MRKane05/PiPortableProject/AdditionalLibraries/NanoPI_Duo2-master/MotherPCB.jpg

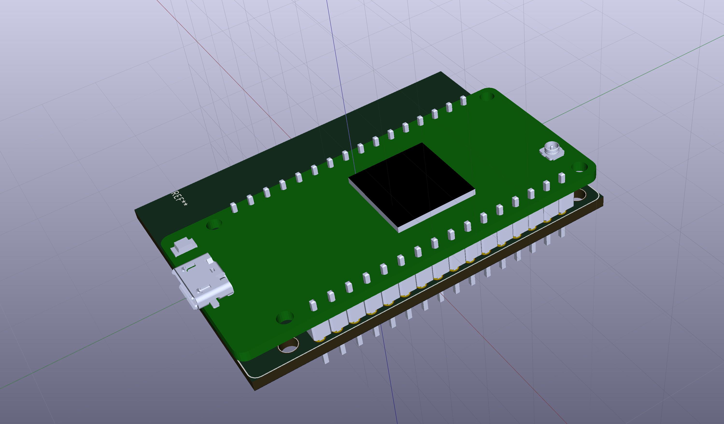
AdditionalLibraries/NanoPI_Duo2-master/MotherPCB.jpg
