MRKane05/PiPortableProject/AdditionalLibraries/NanoPI_Duo2-master/README.md

# NanoPI_Duo2
KICAD Footprint and WRL for the NANOPI DUO2
