MRKane05/PiPortableProject/AdditionalLibraries/NanoPI_Duo2-master/Duo_pinout2-02.jpg

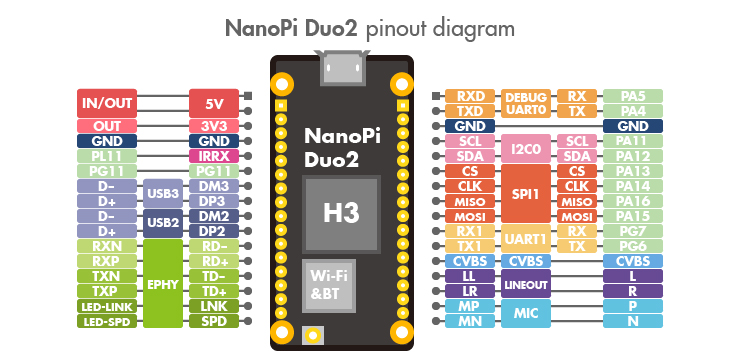
AdditionalLibraries/NanoPI_Duo2-master/Duo_pinout2-02.jpg
