MRKane05/PiPortableProject/(threads)

Thread 1 (2021-07-16):

ATMega32U4

MRKane05, 2021-07-16:
Chip appears to be programmable through both the ISP and USB, but devices won't recognise it as a controller when programmed.

Thread 2 (2021-07-16):

TPS61230 output voltage same as input voltage

MRKane05, 2021-07-16:
The TPS61230 (TP) is supposed to boost the LiPo input voltage up to 5v but for some reason is only outputting the input voltage. I've a suspicion that this is due to the arrangement of the inductors between the TP and BQ25895m (BQ).

Personally I'd like to replace the TP with something that outputs a higher amperage just to cover all bases.

Thread 3 (2021-07-17):

Audio system not working and electrical noise

MRKane05, 2021-07-17:
Raspberry Pi appears to recognise the PCM5102 Audio DAC but isn't pushing any sound through. There's electrical noise on the speakers after the PAM8403 but when headphones are plugged in none is present. I'm yet to test the PAM8403 in isolation.
