MRKane05/PiPortableProject/BoardDesign_FullRouting.pdf

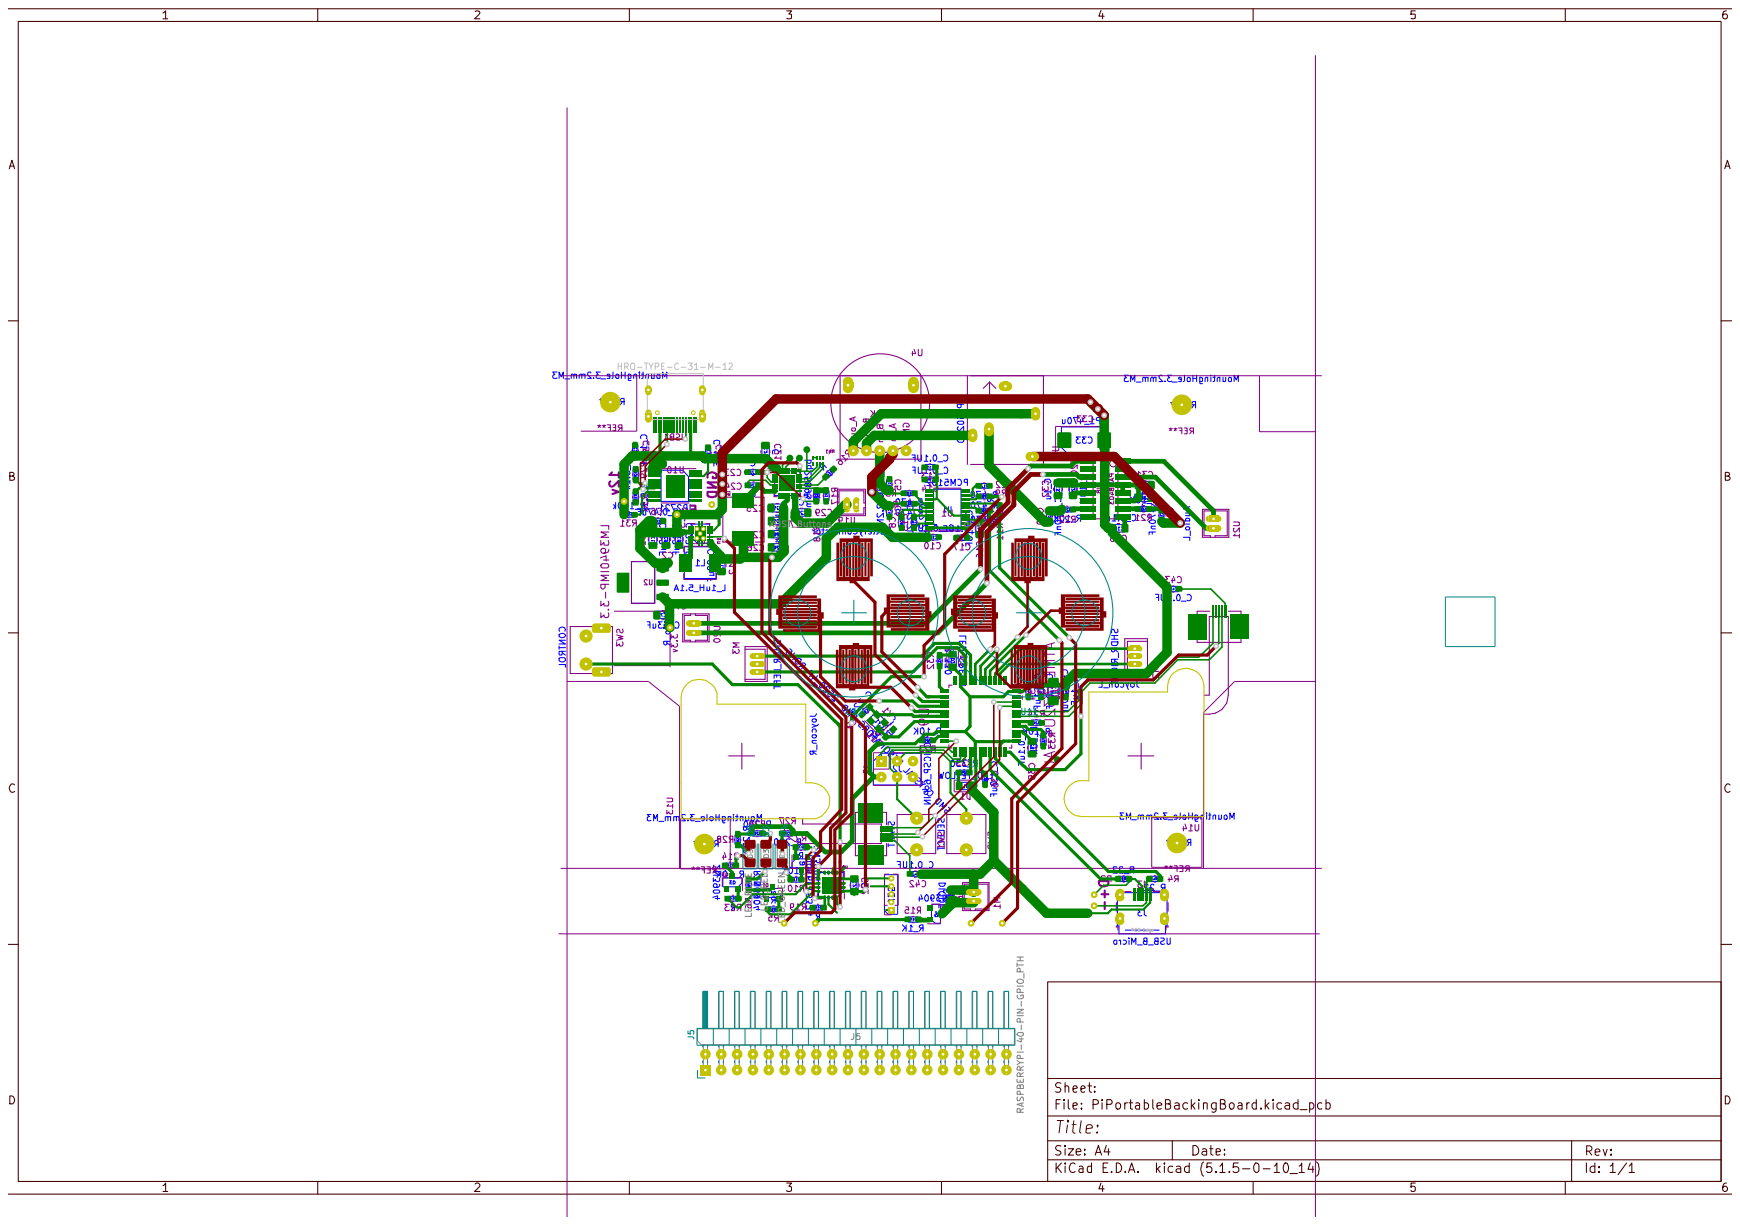
[picture p4: page 1]
