MRKane05/PiPortableProject/PiPortableBackingBoard.kicad_pcb

## KiCad design PiPortableBackingBoard.kicad_pcb (2021-07-16)

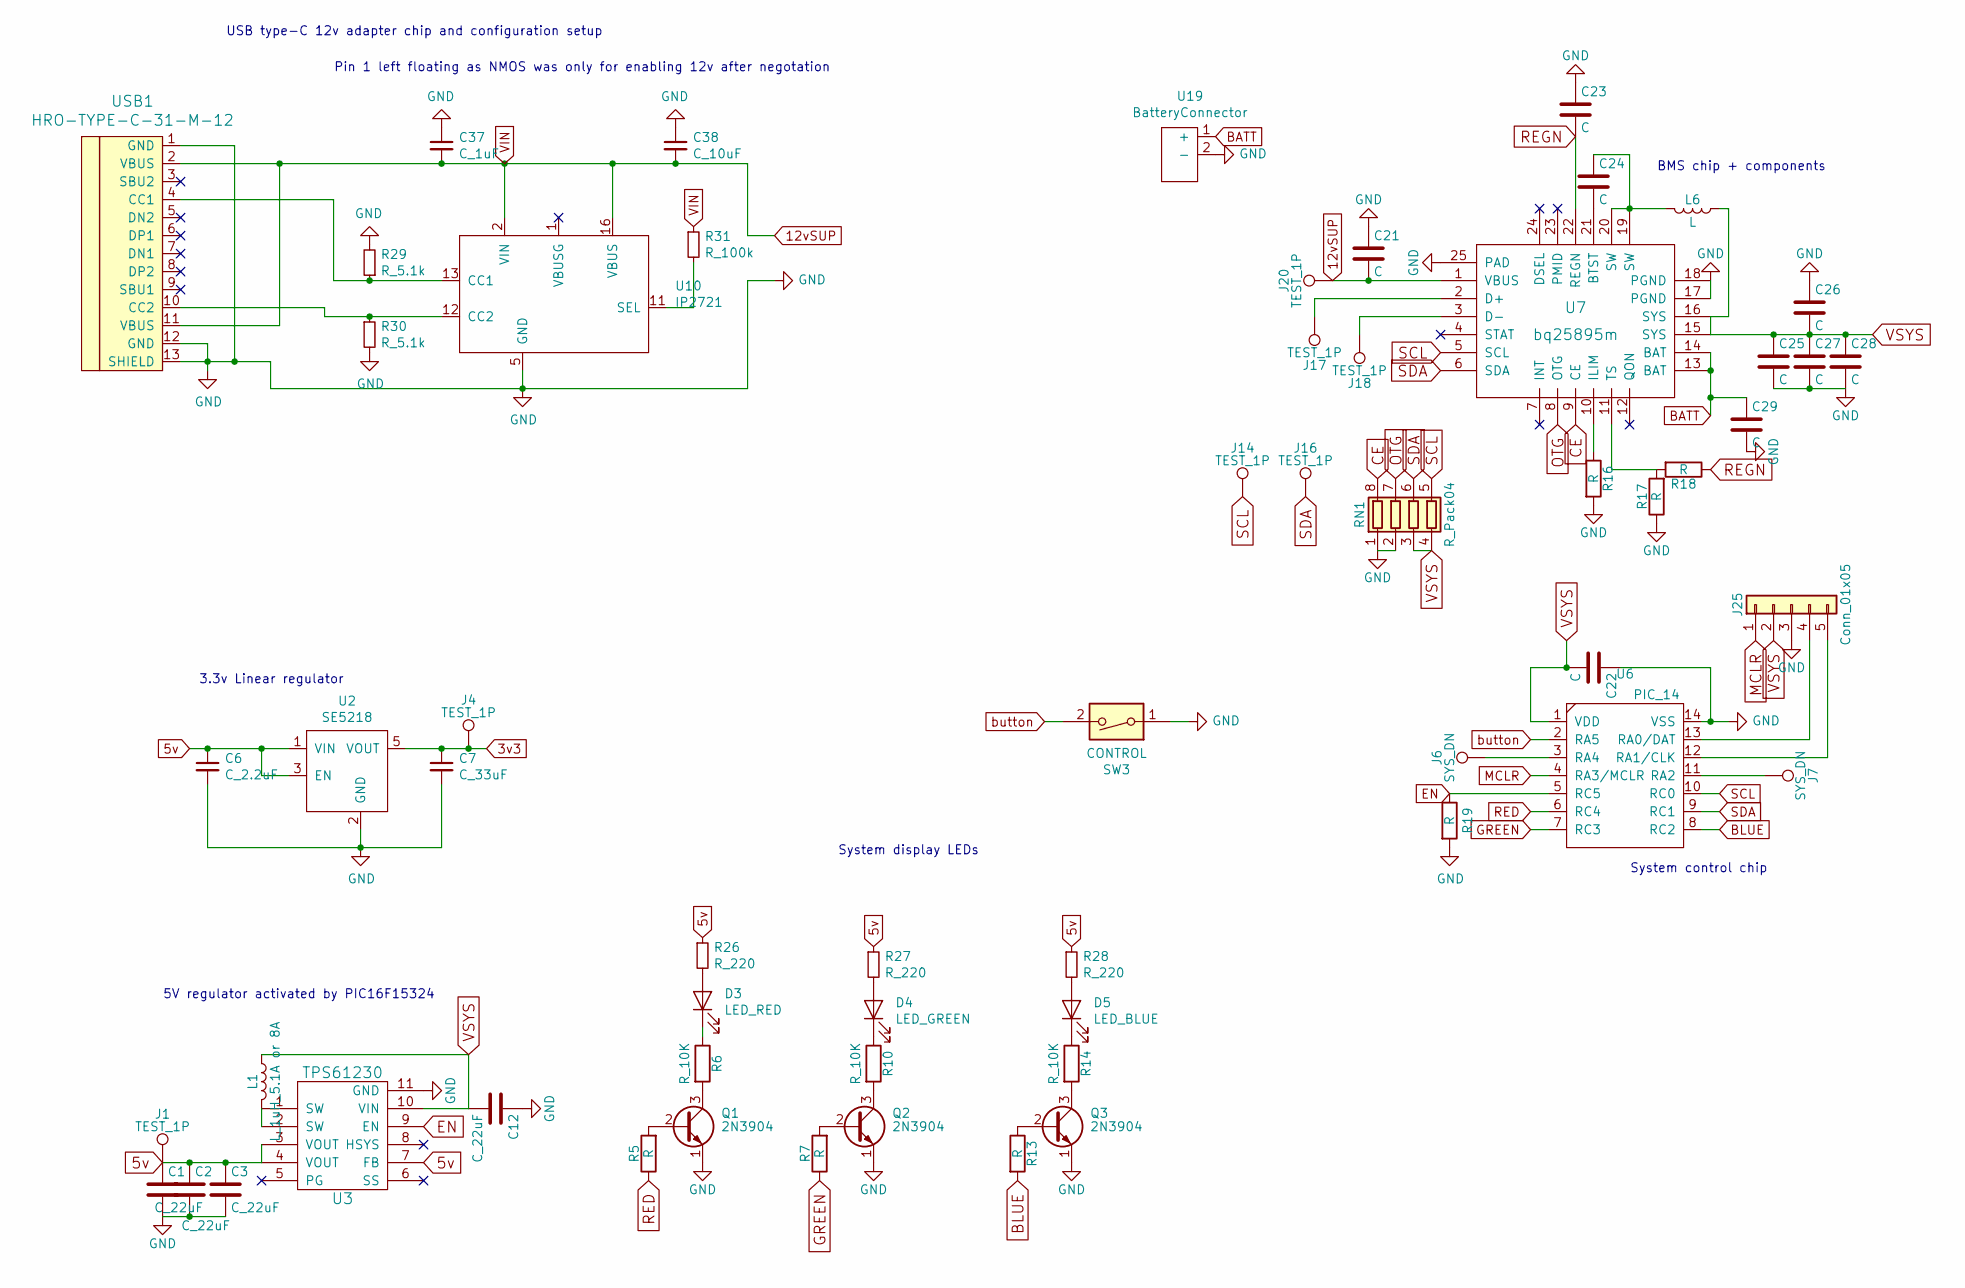
[picture p5: schematic PMSSystem.sch]

Parts:
C1, C2, C3, C12: C_22uF; C_0805_2012Metric_Pad1.15x1.40mm_HandSolder; LCSC C5674
C6: C_2.2uF; C_0603_1608Metric_Pad1.05x0.95mm_HandSolder; LCSC C23630
C7: C_33uF; C_0603_1608Metric_Pad1.05x0.95mm_HandSolder; LCSC C23630
C21, C22, C25, C26, C27, C28, C29: C; C_0805_2012Metric_Pad1.15x1.40mm_HandSolder; LCSC C89190
C23: C; C_0603_1608Metric_Pad1.05x0.95mm_HandSolder; LCSC C19666
C24: C; C_0603_1608Metric_Pad1.05x0.95mm_HandSolder; LCSC C1622
C37: C_1uF; C_0603_1608Metric_Pad1.05x0.95mm_HandSolder; LCSC C15849
C38: C_10uF; C_0603_1608Metric_Pad1.05x0.95mm_HandSolder; LCSC C96446
D3: LED_RED; LED_1206_3216Metric_Pad1.42x1.75mm_HandSolder
D4: LED_GREEN; LED_1206_3216Metric_Pad1.42x1.75mm_HandSolder
D5: LED_BLUE; LED_1206_3216Metric_Pad1.42x1.75mm_HandSolder
J1, J4, J20: TEST_1P; TP1_THT
J6, J7: SYS_DN; TP1_THT
J14, J16, J17, J18: TEST_1P; TP1
J25: Conn_01x05; Pin_Header_Straight_1x05_Pitch1.27mm
L1: L_1uH_5.1A or 8A; ASPI-0630HI-2R2M-T15; LCSC C475532
L6: L; ASPI-0630HI-2R2M-T15; LCSC C475532
Q1, Q2, Q3: 2N3904; SOT-23_custom; LCSC C382287
R5, R7, R13, R17, R18, R19: R; R_0603_1608Metric_Pad1.05x0.95mm_HandSolder; LCSC C25804
R6, R10, R14: R_10K; R_0603_1608Metric_Pad1.05x0.95mm_HandSolder; LCSC C22775
R16: R; R_0603_1608Metric_Pad1.05x0.95mm_HandSolder; LCSC C22925
R26, R27, R28: R_220; R_0603_1608Metric_Pad1.05x0.95mm_HandSolder; LCSC C22962
R29, R30: R_5.1k; R_0603_1608Metric_Pad1.05x0.95mm_HandSolder; LCSC C23186
R31: R_100k; R_0603_1608Metric_Pad1.05x0.95mm_HandSolder; LCSC C25803
RN1: R_Pack04; RA_0804; LCSC C25725
SW3: CONTROL; RightAngleTact
U2: SE5218; SOT-23-5_HandSoldering; LCSC C118233
U3: TPS61230; VSON-10-1EP_3x3mm_Pitch0.5mm_ThermalPad; LCSC C139626
U6: PIC_14; DIP-14_W7.62mm_LongPads
U7: bq25895m; QFN-24-1EP_4x4mm_Pitch0.5mm; LCSC C80200
U10: IP2721; TSSOP-16-1EP_4.4x5mm_P0.65mm_HandSolder
U19: BatteryConnector; JST_1.5_2Pin
USB1: HRO-TYPE-C-31-M-12; HRO-TYPE-C-31-M-12-HandSoldering; LCSC C165948

Connections:
3v3: C7.1, J4.1, U2.5 (VOUT); also elsewhere on the board
5v: C1.1, C2.1, C3.1, C6.1, J1.1, R26.1, R27.1, R28.1, U2.1 (VIN), U2.3 (EN), U3.3 (VOUT), U3.4 (VOUT), U3.7 (FB); also elsewhere on the board
12vSUP: C21.2, C37.2, C38.2, J20.1, R31.1, U7.1 (VBUS), U10.2 (VIN), U10.16 (VBUS), USB1.2 (VBUS), USB1.11 (VBUS)
BATT: C29.1, U7.13 (BAT), U7.14 (BAT), U19.1 (+)
BLUE: R13.2, U6.8 (RC2)
CE: RN1.8 (R1.2), U7.9 (CE)
EN: R19.1, U3.9 (EN), U6.5 (RC5)
GREEN: R7.1, U6.7 (RC3)
MCLR: J25.1, U6.4 (RA3/MCLR)
unnamed: C24.1, L6.2, U7.19 (SW), U7.20 (SW)
unnamed: C24.2, U7.21 (BTST)
unnamed: D3.1 (K), R6.1
unnamed: D3.2 (A), R26.2
unnamed: D4.1 (K), R10.1
unnamed: D4.2 (A), R27.2
unnamed: D5.1 (K), R14.1
unnamed: D5.2 (A), R28.2
unnamed: J6.1, U6.3 (RA4)
unnamed: J7.1, U6.11 (RA2)
unnamed: J17.1, U7.2 (D+)
unnamed: J18.1, U7.3 (D-)
unnamed: J25.4, U6.13 (RA0/DAT)
unnamed: J25.5, U6.12 (RA1/CLK)
unnamed: L1.2, U3.1 (SW), U3.2 (SW)
unnamed: Q1.2 (B), R5.2
unnamed: Q1.3 (C), R6.2
unnamed: Q2.2 (B), R7.2
unnamed: Q2.3 (C), R10.2
unnamed: Q3.2 (B), R13.1
unnamed: Q3.3 (C), R14.2
unnamed: R16.1, U7.10 (ILIM)
unnamed: R17.2, R18.2, U7.11 (TS)
unnamed: R29.1, U10.13 (CC1), USB1.4 (CC1)
unnamed: R30.1, U10.12 (CC2), USB1.10 (CC2)
unnamed: R31.2, U10.11 (SEL)
OTG: RN1.7 (R2.2), U7.8 (OTG)
RED: R5.1, U6.6 (RC4)
REGN: C23.2, R18.1, U7.22 (REGN)
SDA: J16.1, RN1.6 (R3.2), U6.9 (RC1), U7.6 (SDA)
VSYS: C12.2, C22.2, C25.1, C26.2, C27.1, C28.1, J25.2, L1.1, L6.1, RN1.3 (R3.1), RN1.4 (R4.1), U3.10 (VIN), U6.1 (VDD), U7.15 (SYS), U7.16 (SYS)
button: SW3.2, U6.2 (RA5)

Notes on the sheet:
System display LEDs
3.3v Linear regulator
5V regulator activated by PIC16F15324
BMS chip + components
System control chip
USB type-C 12v adapter chip and configuration setup
Pin 1 left floating as NMOS was only for enabling 12v after negotation

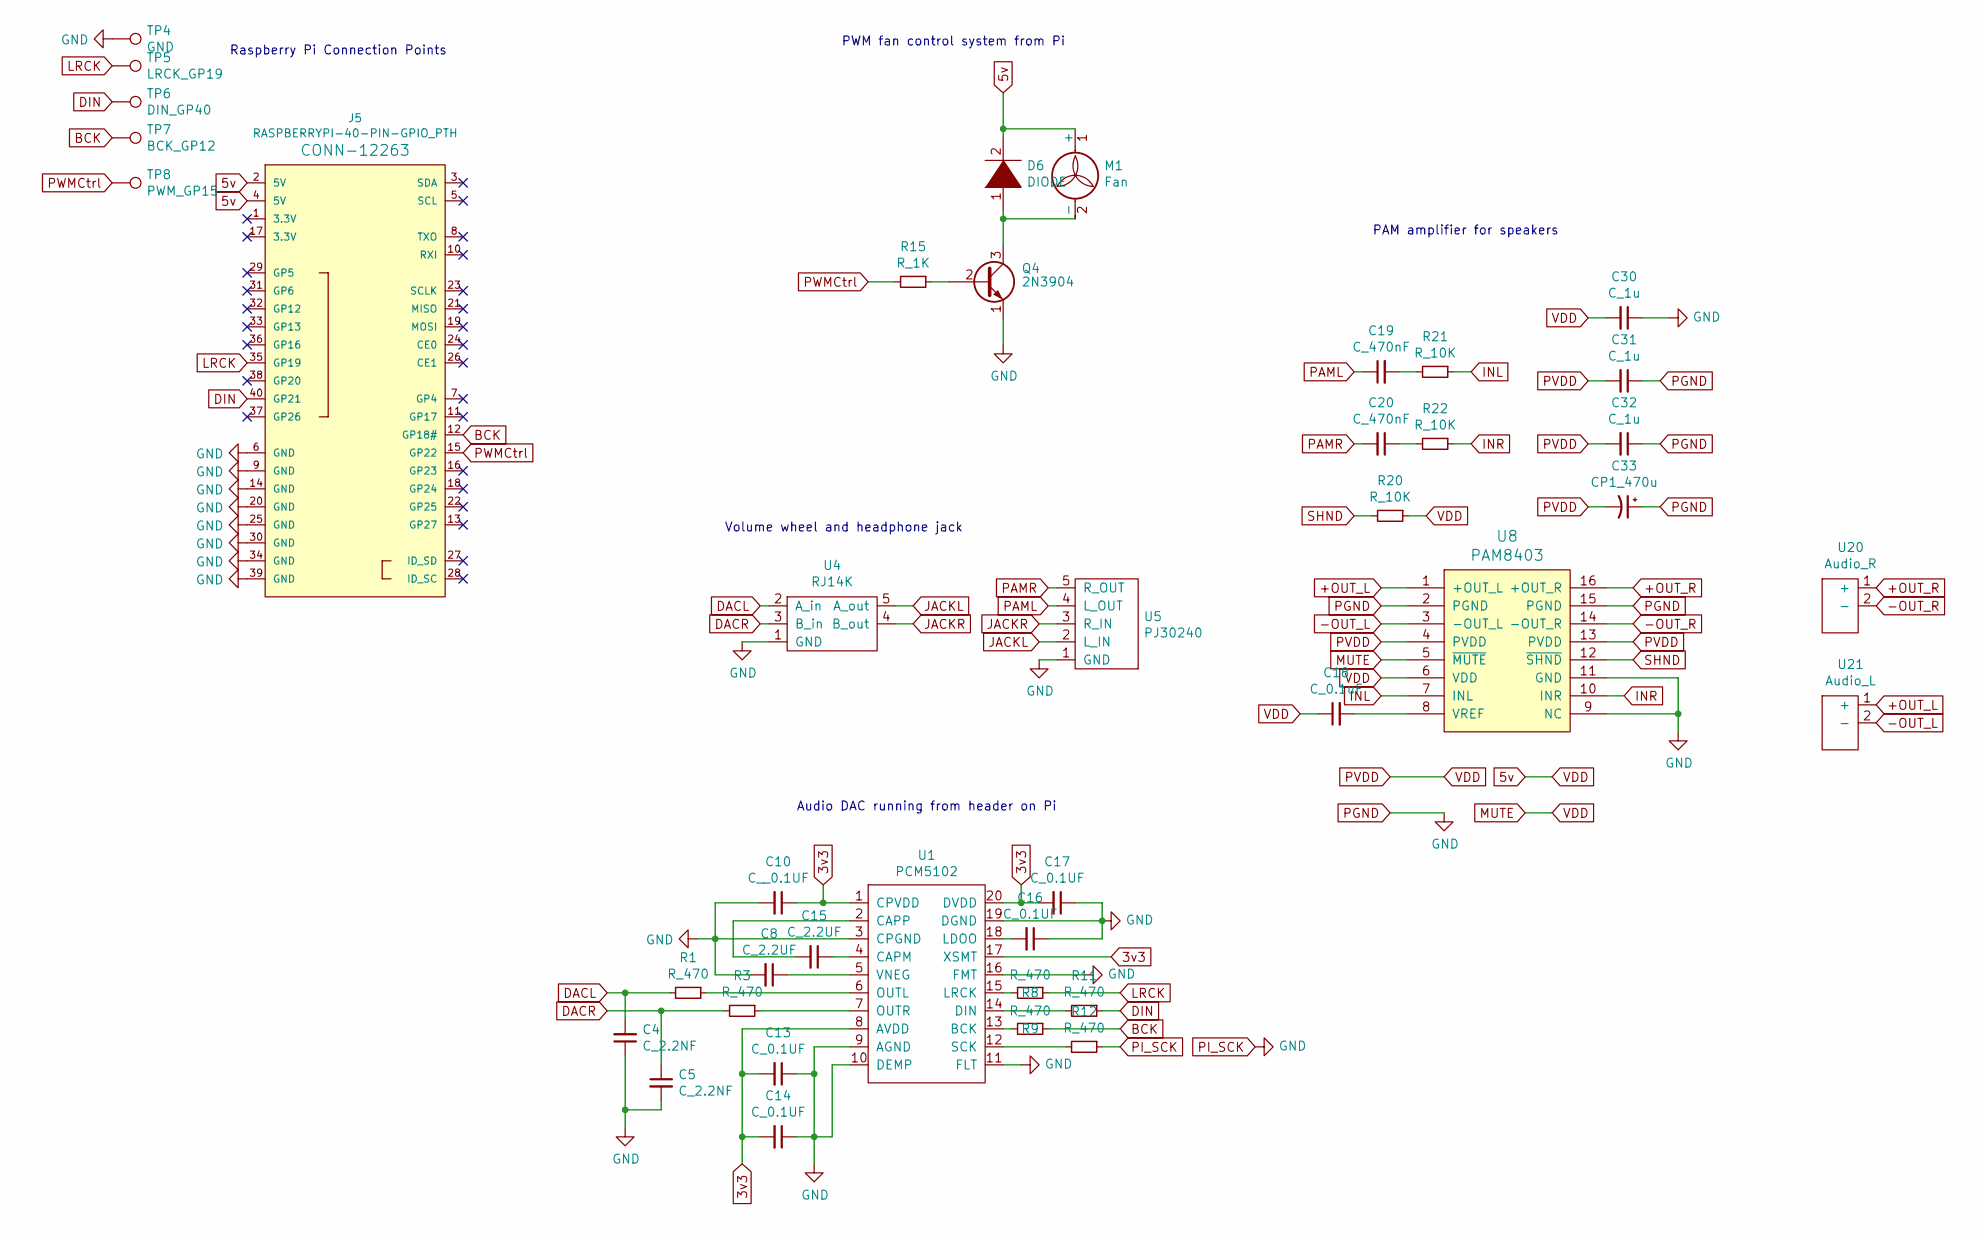
[picture p6: schematic AudioSystem.sch]

Parts:
C4, C5: C_2.2NF; C_0603_1608Metric_Pad1.05x0.95mm_HandSolder; LCSC C1604
C8, C15: C_2.2UF; C_0603_1608Metric_Pad1.05x0.95mm_HandSolder; LCSC C23630
C10: C__0.1UF; C_0603_1608Metric_Pad1.05x0.95mm_HandSolder; LCSC C14663
C13, C14, C17: C_0.1UF; C_0603_1608Metric_Pad1.05x0.95mm_HandSolder; LCSC C14663
C16: C_0.1UF; C_0805_2012Metric_Pad1.15x1.40mm_HandSolder; LCSC C49678
C18: C_0.1uF; C_0805_2012Metric_Pad1.15x1.40mm_HandSolder; LCSC C49678
C19, C20: C_470nF; C_0603_1608Metric_Pad1.05x0.95mm_HandSolder; LCSC C1623
C30, C31, C32: C_1u; C_0805_2012Metric_Pad1.15x1.40mm_HandSolder; LCSC C28323
C33: CP1_470u; CP_EIA-7343-31_Kemet-D_Pad2.25x2.55mm_HandSolder; LCSC C123270
D6: DIODE; C_0603_1608Metric_Pad1.05x0.95mm_HandSolder; LCSC C316055
J5: RASPBERRYPI-40-PIN-GPIO_PTH; PinHeader_2x20_P2.54mm_Horizontal
M1: Fan; JST_1.5_2Pin
Q4: 2N3904; SOT-23_custom; LCSC C382287
R1, R3, R8, R9, R11, R12: R_470; R_0603_1608Metric_Pad1.05x0.95mm_HandSolder; LCSC C23179
R15: R_1K; R_0603_1608Metric_Pad1.05x0.95mm_HandSolder; LCSC C21190
R20: R_10K; R_0805_2012Metric_Pad1.15x1.40mm_HandSolder; LCSC C17414
R21, R22: R_10K; R_0603_1608Metric_Pad1.05x0.95mm_HandSolder
TP4: GND; TP1_THT
TP5: LRCK_GP19; TP1_THT
TP6: DIN_GP40; TP1_THT
TP7: BCK_GP12; TP1_THT
TP8: PWM_GP15; TP1_THT
U1: PCM5102; TSSOP-20_4.4x6.5mm_P0.65mm; LCSC C107671
U4: RJ14K; RJ14K_Modified
U5: PJ30240; AudioJack_PJ30240
U8: PAM8403; so-16; LCSC C17337
U20: Audio_R; JST_1.5_2Pin
U21: Audio_L; JST_1.5_2Pin

Connections:
3v3: C10.1, C13.2, C14.2, C17.2, U1.1 (CPVDD), U1.8 (AVDD), U1.17 (XSMT), U1.20 (DVDD); also elsewhere on the board
5v: C18.1, C30.2, C31.2, C32.2, C33.2, D6.2 (A), J5.2 (5V), J5.4 (5V), M1.1 (+), R20.1, U8.4 (PVDD), U8.5 (~MUTE), U8.6 (VDD), U8.13 (PVDD); also elsewhere on the board
+OUT_L: U8.1 (+OUT_L), U21.1 (+)
+OUT_R: U8.16 (+OUT_R), U20.1 (+)
-OUT_L: U8.3 (-OUT_L), U21.2 (-)
-OUT_R: U8.14 (-OUT_R), U20.2 (-)
BCK: J5.12 (GP18#), R9.1, TP7.1
DACL: C4.2, R1.2, U4.2 (A_in)
DACR: C5.1, R3.2, U4.3 (B_in)
DIN: J5.40 (GP21), R11.1, TP6.1
INL: R21.1, U8.7 (INL)
INR: R22.1, U8.10 (INR)
JACKL: U4.5 (A_out), U5.2 (L_IN)
JACKR: U4.4 (B_out), U5.3 (R_IN)
LRCK: J5.35 (GP19), R8.1, TP5.1
unnamed: C8.1, U1.5 (VNEG)
unnamed: C15.1, U1.4 (CAPM)
unnamed: C15.2, U1.2 (CAPP)
unnamed: C16.2, U1.18 (LDOO)
unnamed: C18.2, U8.8 (VREF)
unnamed: C19.2, R21.2
unnamed: C20.1, R22.2
unnamed: D6.1 (K), M1.2 (-), Q4.3 (C)
unnamed: Q4.2 (B), R15.1
unnamed: R1.1, U1.6 (OUTL)
unnamed: R3.1, U1.7 (OUTR)
unnamed: R8.2, U1.15 (LRCK)
unnamed: R9.2, U1.13 (BCK)
unnamed: R11.2, U1.14 (DIN)
unnamed: R12.2, U1.12 (SCK)
PAML: C19.1, U5.4 (L_OUT)
PAMR: C20.2, U5.5 (R_OUT)
PWMCtrl: J5.15 (GP22), R15.2, TP8.1
SHND: R20.2, U8.12 (~SHND)

Notes on the sheet:
Audio DAC running from header on Pi
Volume wheel and headphone jack
PAM amplifier for speakers
Raspberry Pi Connection Points
PWM fan control system from Pi

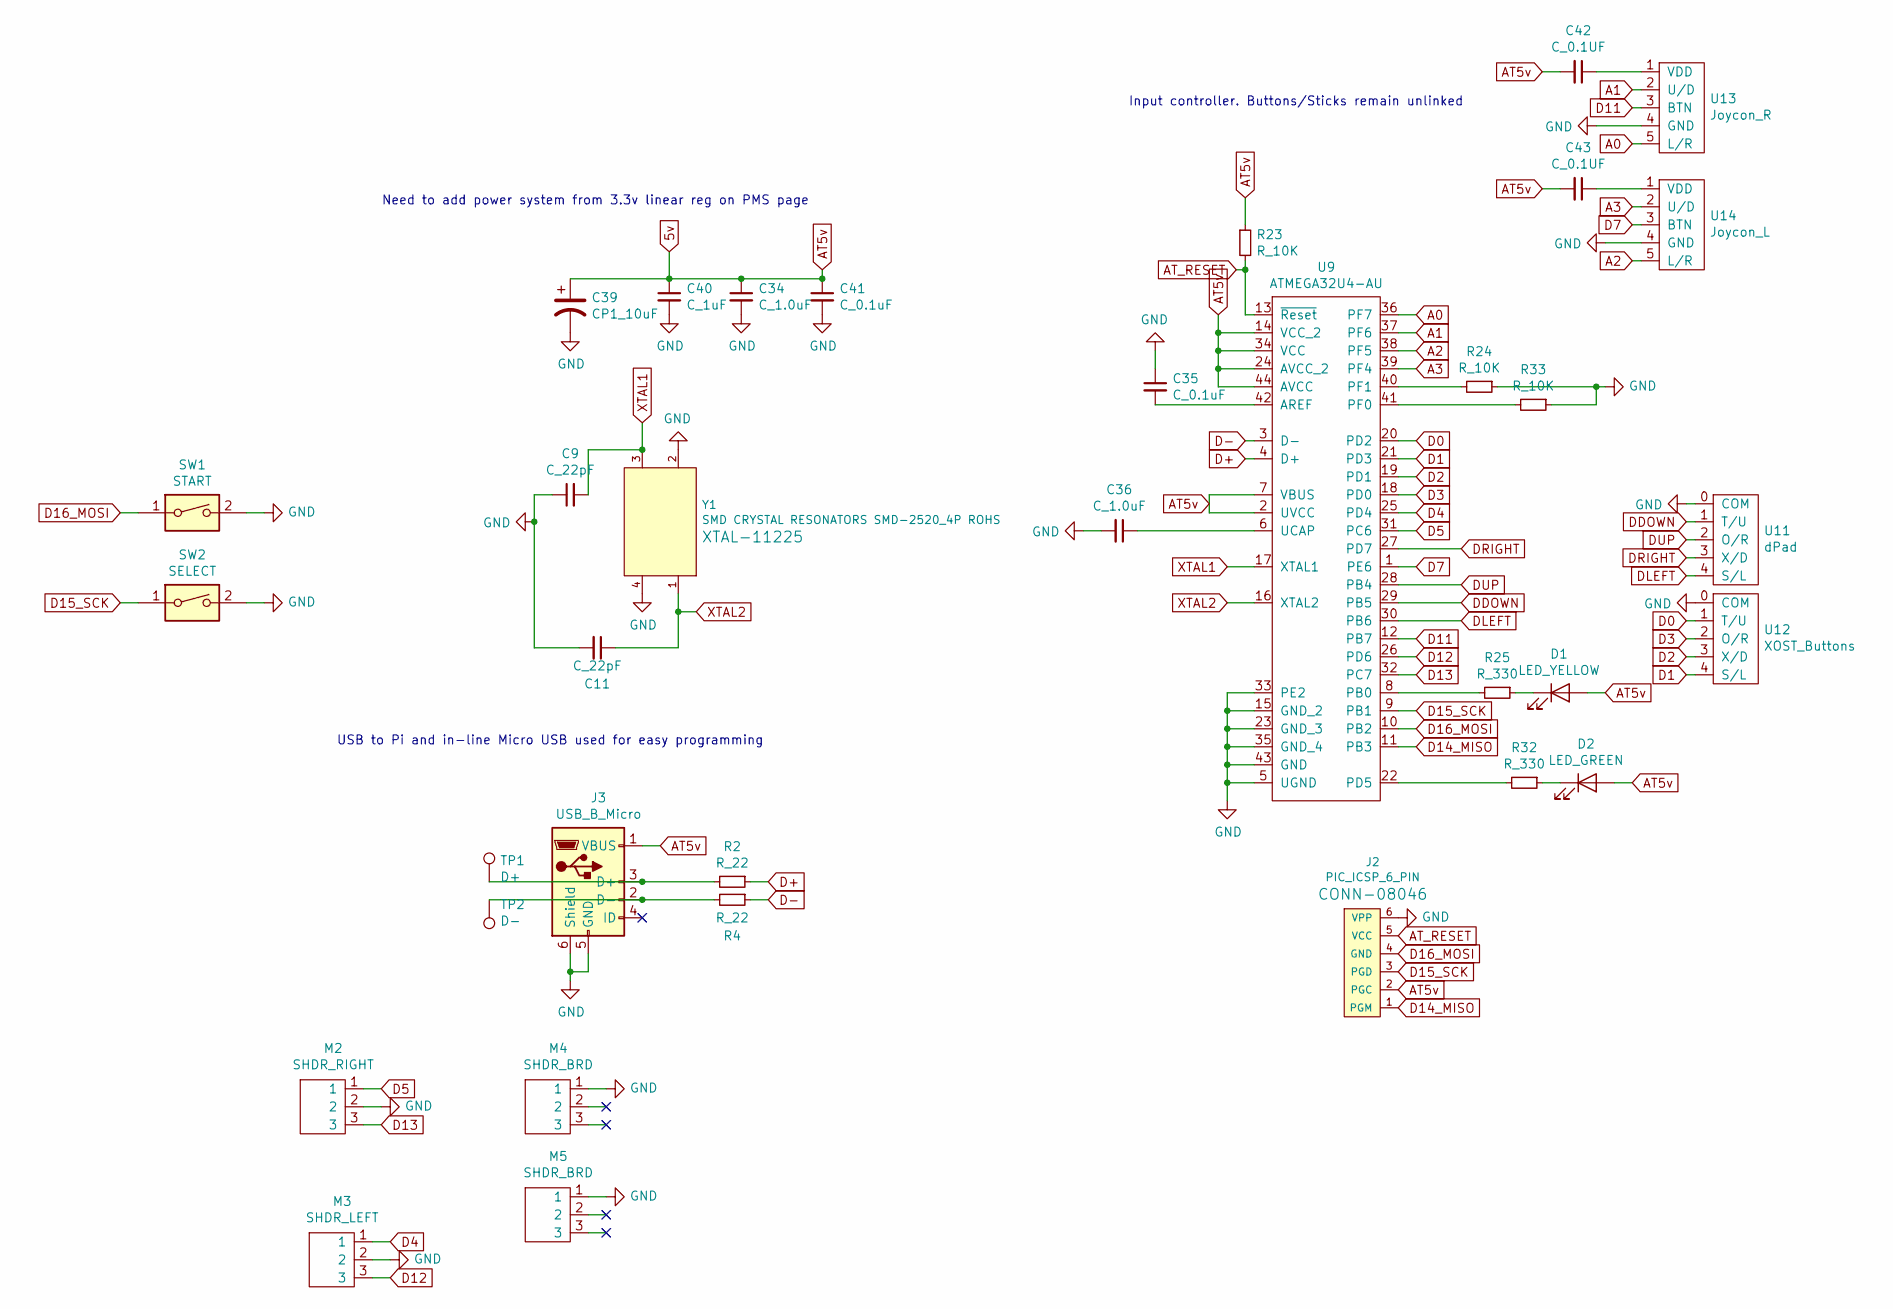
[picture p7: schematic controller.sch]

Parts:
C9, C11: C_22pF; C_0603_1608Metric_Pad1.05x0.95mm_HandSolder; LCSC C1653
C34, C36: C_1.0uF; C_0603_1608Metric_Pad1.05x0.95mm_HandSolder; LCSC C15849
C35: C_0.1uF; C_0805_2012Metric_Pad1.15x1.40mm_HandSolder
C39: CP1_10uF; C_1206_3216Metric_Pad1.42x1.75mm_HandSolder; LCSC C7171
C40: C_1uF; C_0603_1608Metric_Pad1.05x0.95mm_HandSolder; LCSC C15849
C41: C_0.1uF; C_0603_1608Metric_Pad1.05x0.95mm_HandSolder; LCSC C14663
C42, C43: C_0.1UF; C_0603_1608Metric_Pad1.05x0.95mm_HandSolder; LCSC C14663
D1: LED_YELLOW; LED_0805_2012Metric_Pad1.15x1.40mm_HandSolder; LCSC C2296
D2: LED_GREEN; LED_0805_2012Metric_Pad1.15x1.40mm_HandSolder; LCSC C63855
J2: PIC_ICSP_6_PIN; PinHeader_2x03_P2.54mm_Vertical
J3: USB_B_Micro; USB_Micro-B_C456008; LCSC C456008
M2: SHDR_RIGHT; JST_1.25_3Pin
M3: SHDR_LEFT; JST_1.25_3Pin
M4, M5: SHDR_BRD; Pi_Shoulders
R2, R4: R_22; R_0603_1608Metric_Pad1.05x0.95mm_HandSolder; LCSC C149625
R23, R24, R33: R_10K; R_0603_1608Metric_Pad1.05x0.95mm_HandSolder
R25, R32: R_330; R_0603_1608Metric_Pad1.05x0.95mm_HandSolder; LCSC C23138
SW1: START; HardTact
SW2: SELECT; HardTact
TP1: D+; TP1_THT
TP2: D-; TP1_THT
U9: ATMEGA32U4-AU; ATmega32U4; LCSC C44854
U11: dPad; PiD-Pad
U12: XOST_Buttons; PiD-Pad
U13: Joycon_R; Switch_Stick_Styler; LCSC C262261
U14: Joycon_L; Switch_Stick_Styler; LCSC C262261
Y1: SMD CRYSTAL RESONATORS SMD-2520_4P ROHS; Crystal_SMD_2520-4Pin_2.5x2.0mm; LCSC C284159

Connections:
5v: C34.1, C39.1, C40.1, C41.1, C42.2, C43.2, D1.2 (A), D2.2 (A), J2.2 (PGC), J3.1 (VBUS), R23.1, U9.2 (UVCC), U9.7 (VBUS), U9.14 (VCC_2), U9.24 (AVCC_2), U9.34 (VCC), U9.44 (AVCC); also elsewhere on the board
A0: U9.36 (PF7), U13.5 (L/R)
A1: U9.37 (PF6), U13.2 (U/D)
A2: U9.38 (PF5), U14.5 (L/R)
A3: U9.39 (PF4), U14.2 (U/D)
AT_RESET: J2.5 (VCC), R23.2, U9.13 (~Reset)
D0: U9.20 (PD2), U12.1 (T/U)
D1: U9.21 (PD3), U12.4 (S/L)
D2: U9.19 (PD1), U12.3 (X/D)
D3: U9.18 (PD0), U12.2 (O/R)
D4: M3.1, U9.25 (PD4)
D5: M2.1, U9.31 (PC6)
D7: U9.1 (PE6), U14.3 (BTN)
D11: U9.12 (PB7), U13.3 (BTN)
D12: M3.3, U9.26 (PD6)
D13: M2.3, U9.32 (PC7)
D14_MISO: J2.1 (PGM), U9.11 (PB3)
D15_SCK: J2.3 (PGD), SW2.1, U9.9 (PB1)
D16_MOSI: J2.4 (GND), SW1.1, U9.10 (PB2)
D+: R2.1, U9.4 (D+)
D-: R4.1, U9.3 (D-)
DDOWN: U9.29 (PB5), U11.1 (T/U)
DLEFT: U9.30 (PB6), U11.4 (S/L)
DRIGHT: U9.27 (PD7), U11.3 (X/D)
DUP: U9.28 (PB4), U11.2 (O/R)
unnamed: C35.2, U9.42 (AREF)
unnamed: C36.1, U9.6 (UCAP)
unnamed: C42.1, U13.1 (VDD)
unnamed: C43.1, U14.1 (VDD)
unnamed: D1.1 (K), R25.1
unnamed: D2.1 (K), R32.1
unnamed: J3.2 (D-), R4.2, TP2.1
unnamed: J3.3 (D+), R2.2, TP1.1
unnamed 78: M4.2; also elsewhere on the board
unnamed: R24.2, U9.40 (PF1)
unnamed: R25.2, U9.8 (PB0)
unnamed: R32.2, U9.22 (PD5)
unnamed: R33.2, U9.41 (PF0)
XTAL1: C9.2, U9.17 (XTAL1), Y1.3 (OUT)
XTAL2: C11.1, U9.16 (XTAL2), Y1.1 (EN)

Notes on the sheet:
Need to add power system from 3.3v linear reg on PMS page
USB to Pi and in-line Micro USB used for easy programming
Input controller. Buttons/Sticks remain unlinked

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
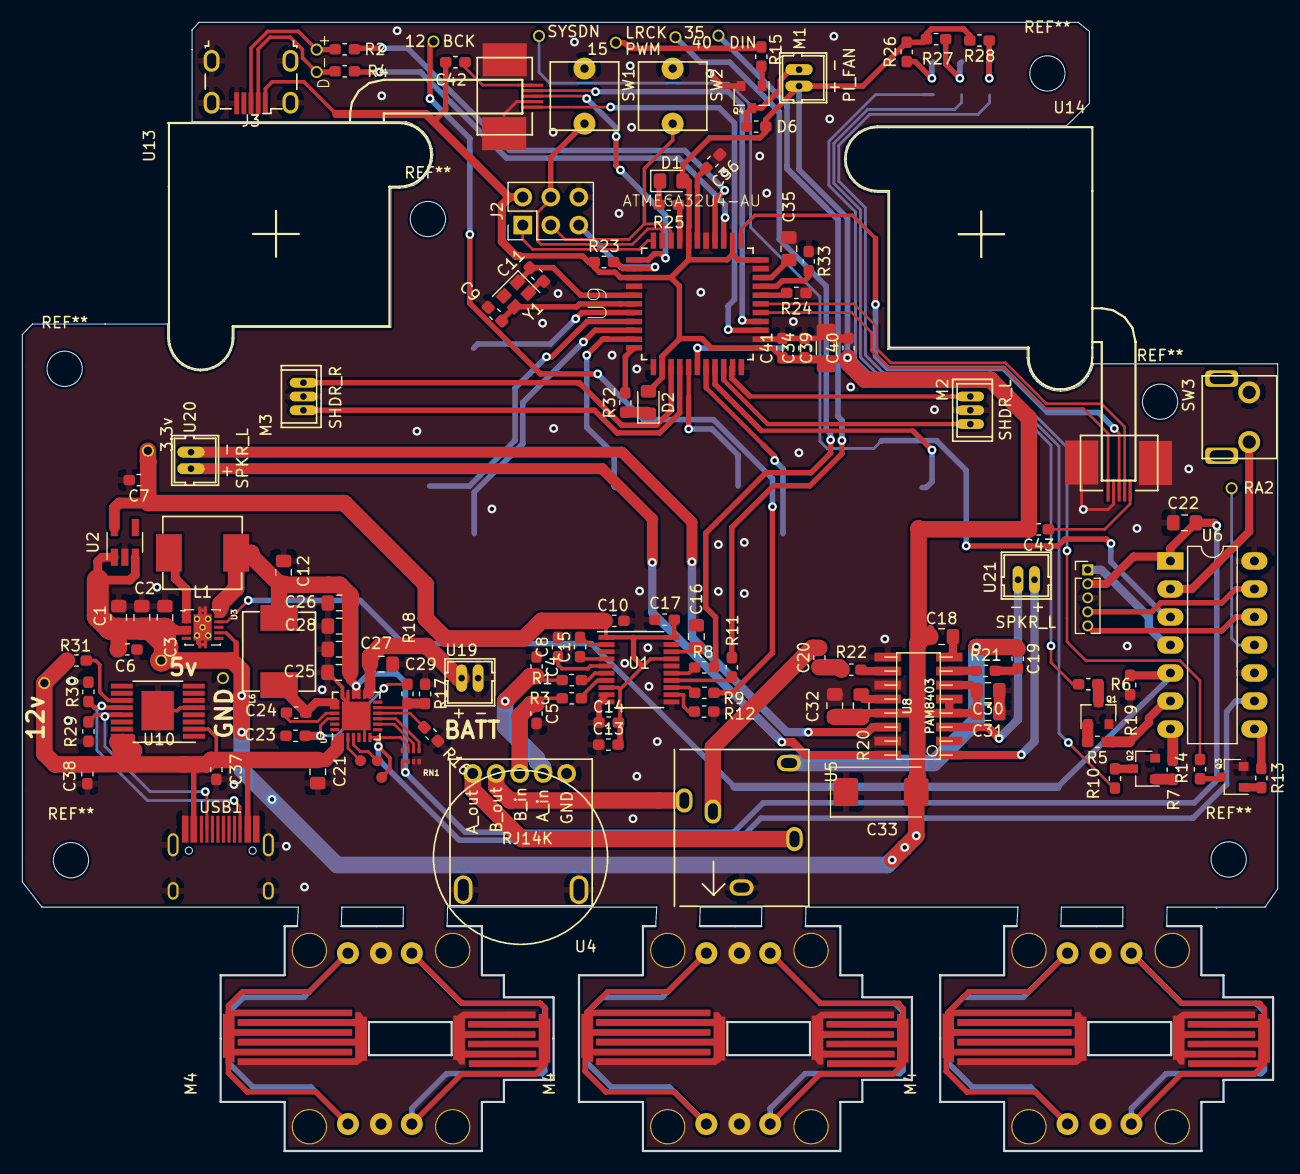
[picture p8: board PiPortableBackingBoard.kicad_pcb from above]

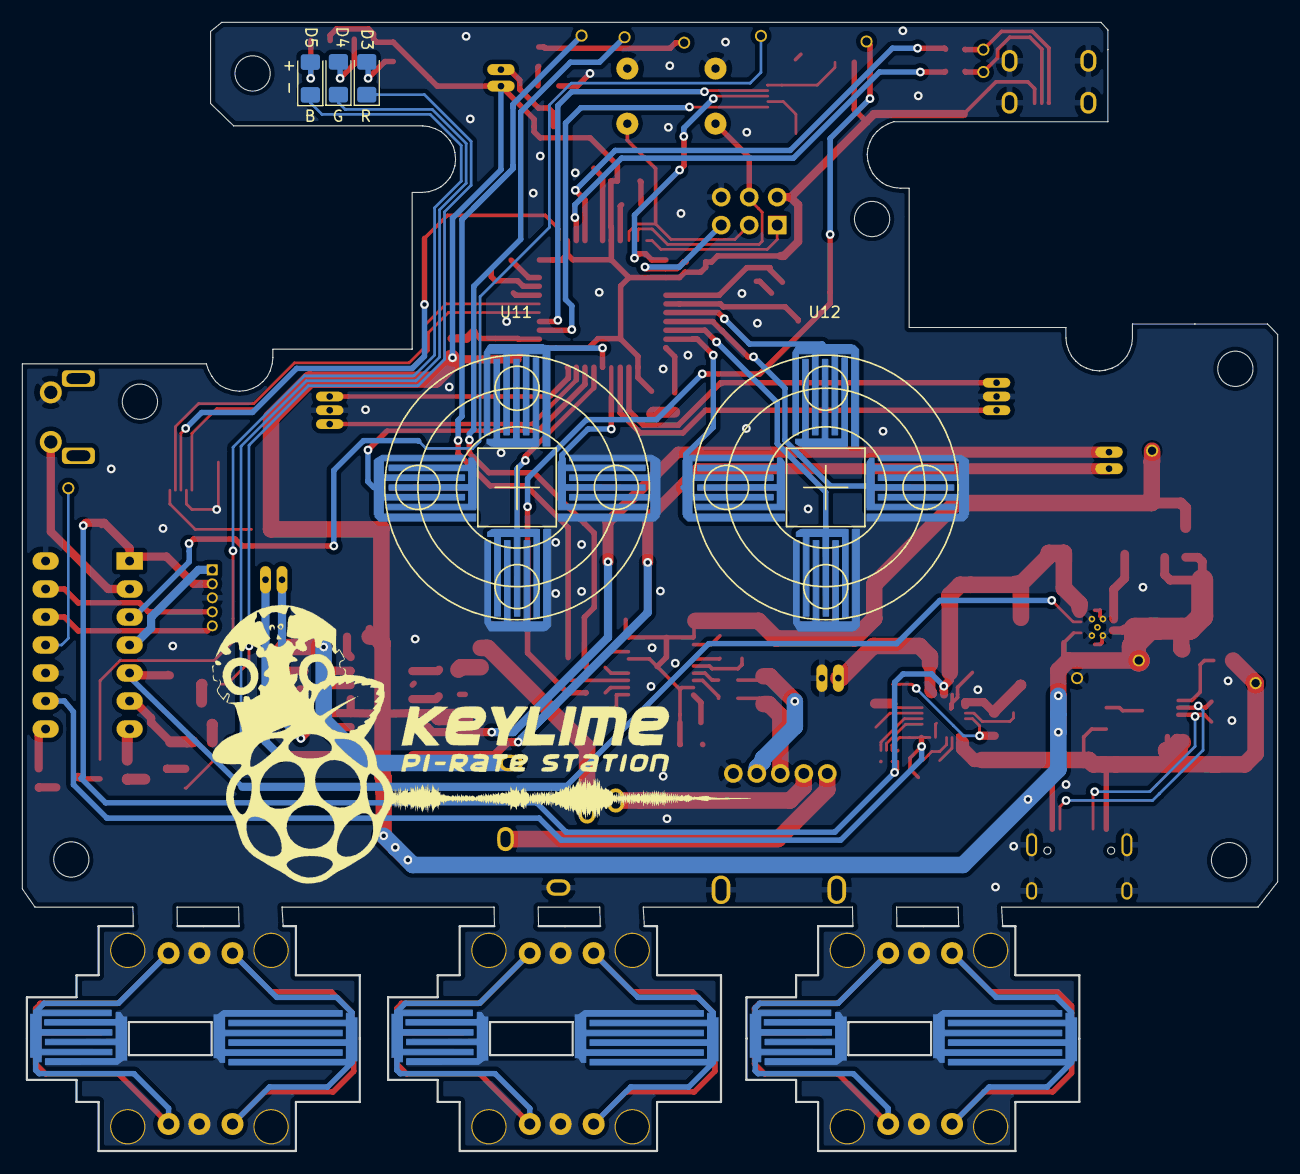
[picture p9: board PiPortableBackingBoard.kicad_pcb from below]

Board: 2 copper layers, 113.9 x 102.4 mm, 135 parts (5 on the bottom side), 113 nets.

Other parts of the board:
M4#2, M4#3: SHDR_BRD; Pi_Shoulders

Their connections:
unnamed 78: M4#2.2, M4#3.2; also elsewhere on the board
